simonem/WATCHiT/hardware/schematics/arduino.png

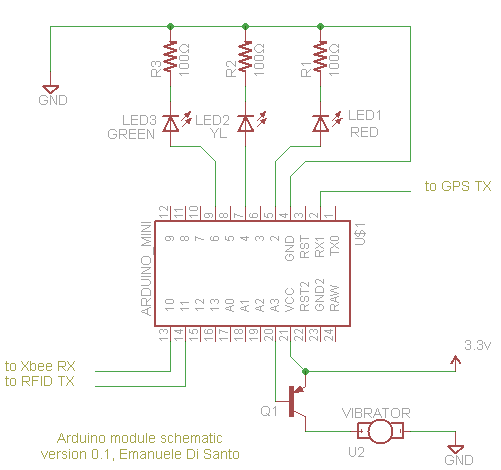
hardware/schematics/arduino.png
