simonem/WATCHiT/hardware/schematics/gps.png

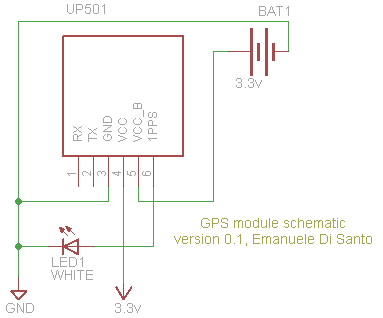
hardware/schematics/gps.png
