simonem/WATCHiT/hardware/schematics/power.png

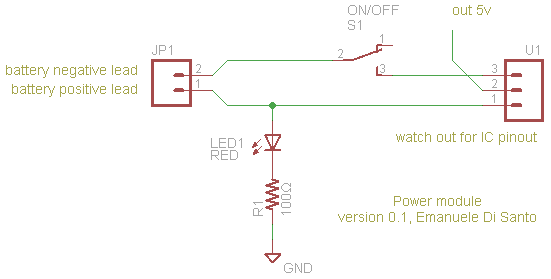
hardware/schematics/power.png
