simonem/WATCHiT/hardware/schematics/rfid.png

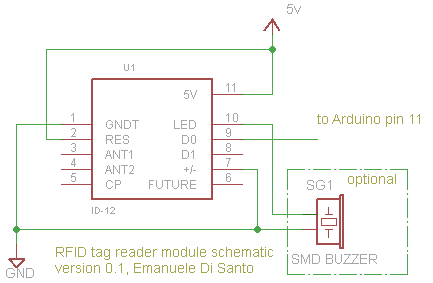
hardware/schematics/rfid.png
