simonem/WATCHiT/hardware/schematics/xbee.png

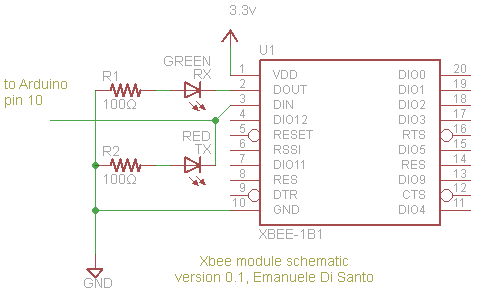
hardware/schematics/xbee.png
