simonem/WATCHiT/hardware/boxes/module-main/LEMBOX-01.stl

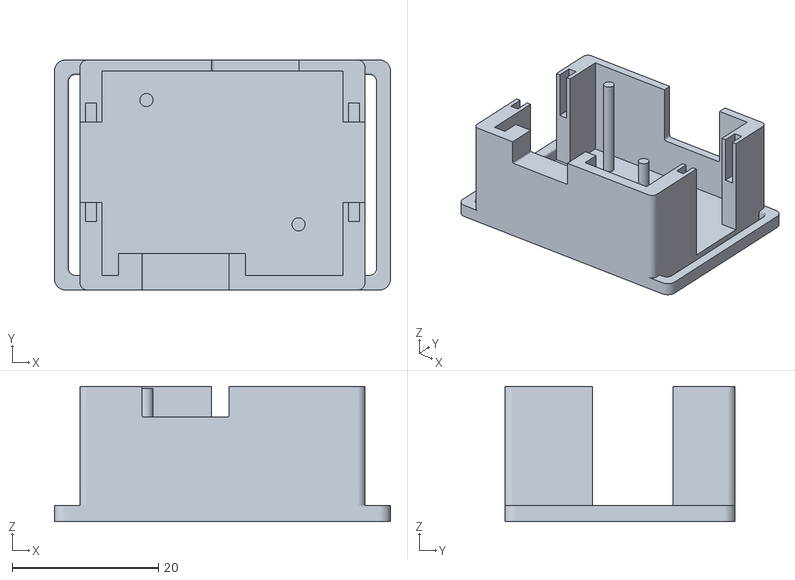
[picture p7: CAD file, 2014-01-15]
hardware/boxes/module-main/LEMBOX-01.stl
46.0 x 31.5 x 18.5
