simonem/WATCHiT/hardware/boxes/module-rfid/LEMBOX-06.stl

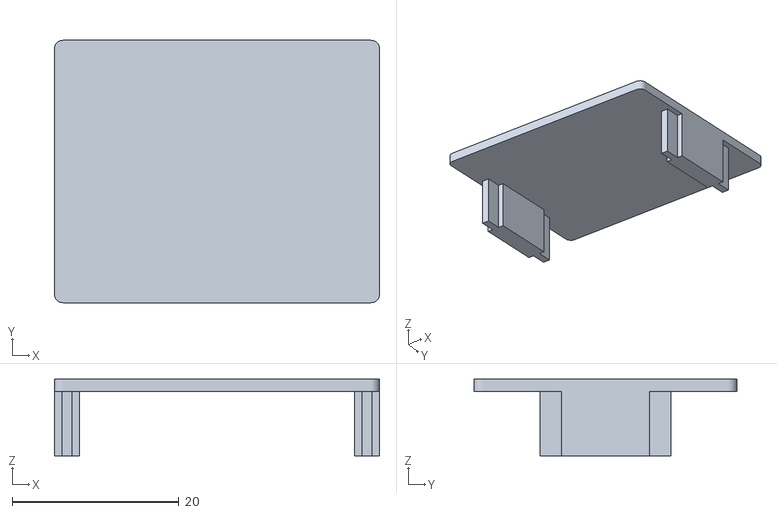
[picture p8: CAD file, 2014-01-15]
hardware/boxes/module-rfid/LEMBOX-06.stl
39.0 x 31.5 x 9.20
