simonem/WATCHiT/hardware/boxes/module-main/LEMBOX-04.stl

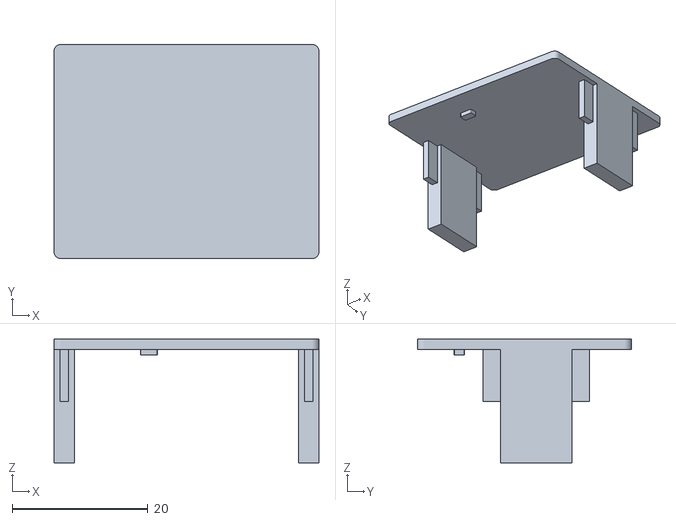
[picture p9: CAD file, 2014-01-15]
hardware/boxes/module-main/LEMBOX-04.stl
39.0 x 31.5 x 18.2
