simonem/WATCHiT/hardware/boxes/module-rfid/LEMBOX-05.stl

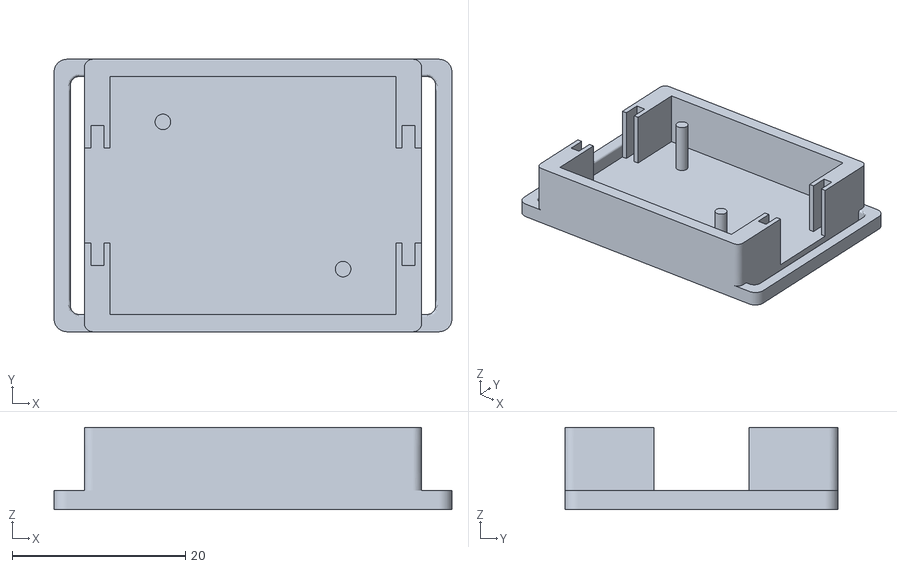
[picture p10: CAD file, 2014-01-15]
hardware/boxes/module-rfid/LEMBOX-05.stl
46.0 x 31.5 x 9.50
