simonem/WATCHiT/hardware/schematics/arduino.sch

## EAGLE design hardware/schematics/arduino.sch (2013-02-22)

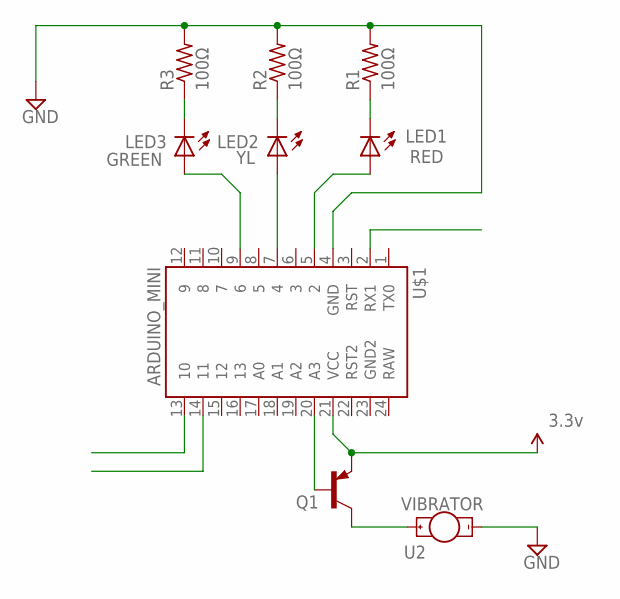
[picture p11: schematic arduino.sch]

Parts:
LED1: RED; CHIPLED_0805
LED2: YL; CHIPLED_0805
LED3: GREEN; CHIPLED_0805
Q1: -PNP-TO92; TO92
R1, R2, R3: 100Ω; R3216
U2: VIBRATOR; VIBE-MOTOR-10MM
U$1: ARDUINO_MINI

Connections:
GND: R1.2, R2.2, R3.2, U2.-, U$1.4 (GND)
unnamed: LED1.C, R1.1
unnamed: LED1.A, U$1.5 (2)
unnamed: LED2.C, R2.1
unnamed: LED3.C, R3.1
unnamed: LED2.A, U$1.7 (4)
unnamed: LED3.A, U$1.9 (6)
unnamed: Q1.2 (B), U$1.20 (A3)
unnamed: Q1.3 (C), U2.+
VCC: Q1.1 (E), U$1.21 (VCC)
