simonem/WATCHiT/hardware/schematics/gps.sch

## EAGLE design hardware/schematics/gps.sch (2013-02-22)

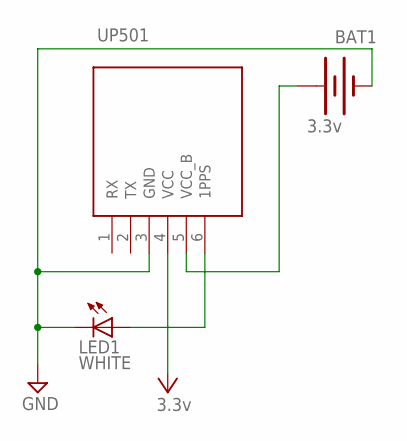
[picture p12: schematic gps.sch]

Parts:
BAT1: 3.3v; BATTCON_12MM
LED1: WHITE; CHIPLED_0805
U1: UP501; 1X06

Connections:
GND: BAT1.GND (-), LED1.C, U1.3 (GND)
unnamed: BAT1.PWR@1 (+), U1.5 (VCC_B)
unnamed: LED1.A, U1.6 (1PPS)
VCC: U1.4 (VCC)

Notes on the sheet:
UP501
