simonem/WATCHiT/hardware/schematics/power.sch

## EAGLE design hardware/schematics/power.sch (2013-02-22)

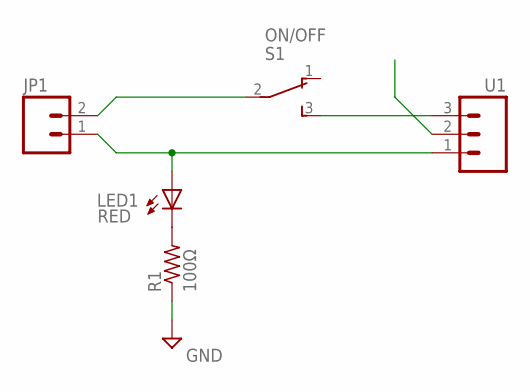
[picture p13: schematic power.sch]

Parts:
JP1: M02JST-PTH-2; JST-2-PTH
LED1: RED; CHIP-LED0805
R1: 100Ω; M3216
S1: ON/OFF; TL3XPO
U1: M03PTH; 1X03

Connections:
GND: R1.1
unnamed: JP1.1, LED1.A, U1.1
unnamed: JP1.2, S1.2
unnamed: LED1.C, R1.2
unnamed: S1.3 (S), U1.3
