simonem/WATCHiT/hardware/schematics/rfid.sch

## EAGLE design hardware/schematics/rfid.sch (2013-02-22)

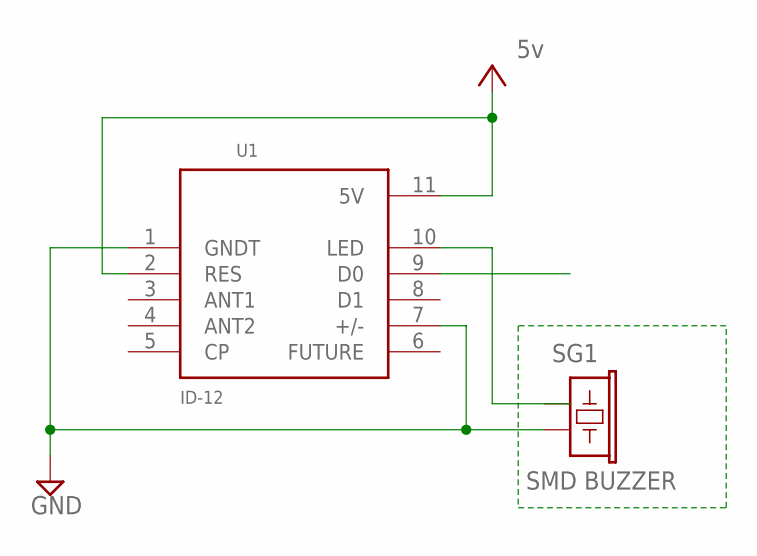
[picture p14: schematic rfid.sch]

Parts:
SG1: SMD BUZZER; BUZZER-CCV
U1: ID-12

Connections:
GND: SG1.- (2), U1.1 (GNDT), U1.7 (+/-)
VCC: U1.2 (RES), U1.11 (5V)
