simonem/WATCHiT/hardware/schematics/xbee.sch

## EAGLE design hardware/schematics/xbee.sch (2013-02-22)

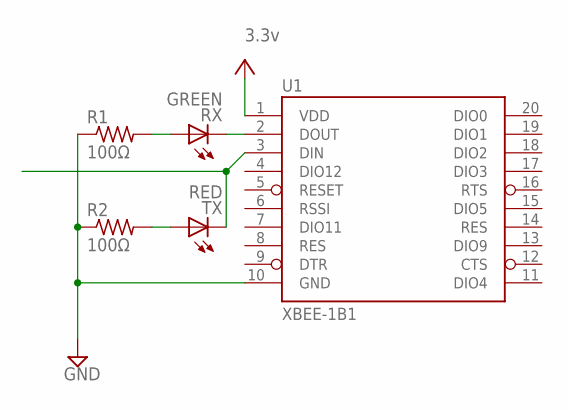
[picture p15: schematic xbee.sch]

Parts:
R1, R2: 100Ω; R3216
RX: GREEN; CHIP-LED0805
TX: RED; CHIP-LED0805
U1: XBEE-1B1; XBEE-1

Connections:
GND: R1.1, R2.1, U1.10 (GND)
unnamed: RX.C, U1.2 (DOUT)
unnamed: TX.C, U1.3 (DIN)
unnamed: R1.2, RX.A
unnamed: R2.2, TX.A
VCC: U1.1 (VDD)
