simonem/WATCHiT/(commit log)

2013-02-22 Added schematics
    [arduino.sch, gps.sch, power.sch, rfid.sch, xbee.sch]
2013-02-22 Revert "Added schematics"
    This reverts commit 8e36b7412e574f99e16c52693f779ec6f1f40ac8.
    [arduino.sch, gps.sch, power.sch, rfid.sch, xbee.sch]
2013-02-22 Schematics added
    [arduino.sch, gps.sch, power.sch, rfid.sch, xbee.sch]
2013-03-12 Cleanup of code for the non-GPS version of the prototype
    To be run only with CPU, Comm (BT), RFID and power modules.
    Requires a gateway.
2013-04-03 Fixed mispelled tag ID
    [WATCHiTv3.ino]
2014-01-15 Added STL files and code for the new prototype (version 4).
    [LEMBOX-01.stl, LEMBOX-04.stl, LEMBOX-05.stl, LEMBOX-06.stl]
