simonem/WATCHiT/(notices)

Notices in the files:
software/WATCHiTv3/WATCHiTv3.ino:
Copyright (c) 2013, Emanuele Di Santo, Simone Mora
All rights reserved.
parts and their libraries:
SparkFun-Boards: Licensing: CC v3.0 Share-Alike You are welcome to use this library for commercial purposes.
